dotdash32/VoronUsers/printer_mods/Dotdash32/SKR_E3_Mini_V2_Expanders/ThermistorExpander-kicad/THermistorExpander-kicad_toLCSC.csv

Manufacture Part Number | Description | Value | Manufacturer | LCSC Part Number | Quantity | Unit Price | Order Price | $1.02
GRM21BR61H106KE43L | C2, C3, C4, | 10uF | Murata Electronics | C440198 | 3 | $0.1030 | $0.31
PM254V-12-08-H85 | J1 | SPI_Header | XFCN | C541854 | 1 | $0.1424 | $0.14
B2B-XH-AM(LF)(SN) | J2, J3, J4 | JST-XH-B2B | JST Sales America | C161869 | 3 | $0.0512 | $0.15
XHP-2 | J2-4 Housings | JST-XHP-2 | JST Sales America | C144401 | 3 | $0.0221 | $0.07
SXH-002T-P0.6 | J2-4 crimps | SXH | JST Sales America | C495681 | 6 | $0.0586 | $0.35
