dotdash32/VoronUsers/printer_mods/Dotdash32/SKR_E3_Mini_V2_Expanders/FanExpander-Lite/FanExpander-Lite.step

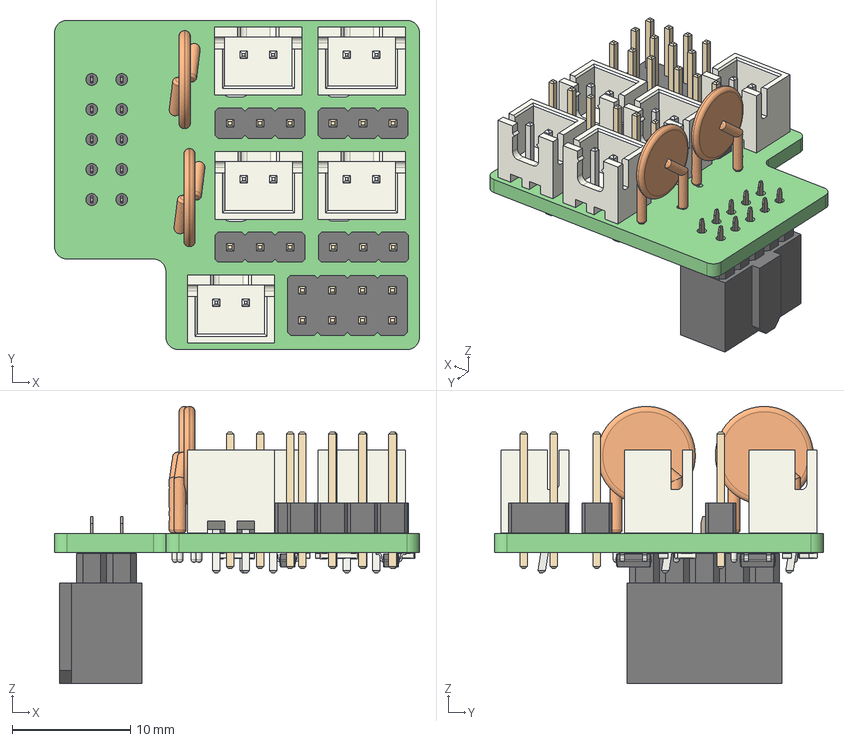
[picture p1: CAD file, 2022-02-04]
printer_mods/Dotdash32/SKR_E3_Mini_V2_Expanders/FanExpander-Lite/FanExpander-Lite.step
30.9 x 27.9 x 23.4 mm
_autosave-FanExpander-Lite PCB
