dotdash32/VoronUsers/printer_mods/Dotdash32/SKR_E3_Mini_V2_Expanders/Solder-Stencils/Fan-exp/FanExpander-kicad-Edge_Cuts.dxf

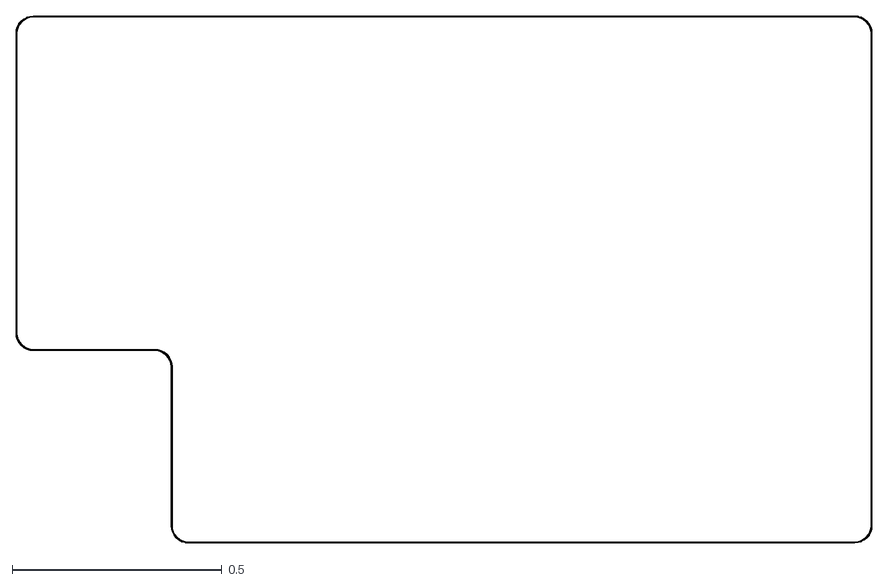
[picture p2: CAD file, 2022-02-01]
printer_mods/Dotdash32/SKR_E3_Mini_V2_Expanders/Solder-Stencils/Fan-exp/FanExpander-kicad-Edge_Cuts.dxf
2.04 x 1.26
