dotdash32/VoronUsers/printer_mods/Dotdash32/SKR_E3_Mini_V2_Expanders/Solder-Stencils/FEL/FanExpander-Lite-Edge_Cuts.dxf

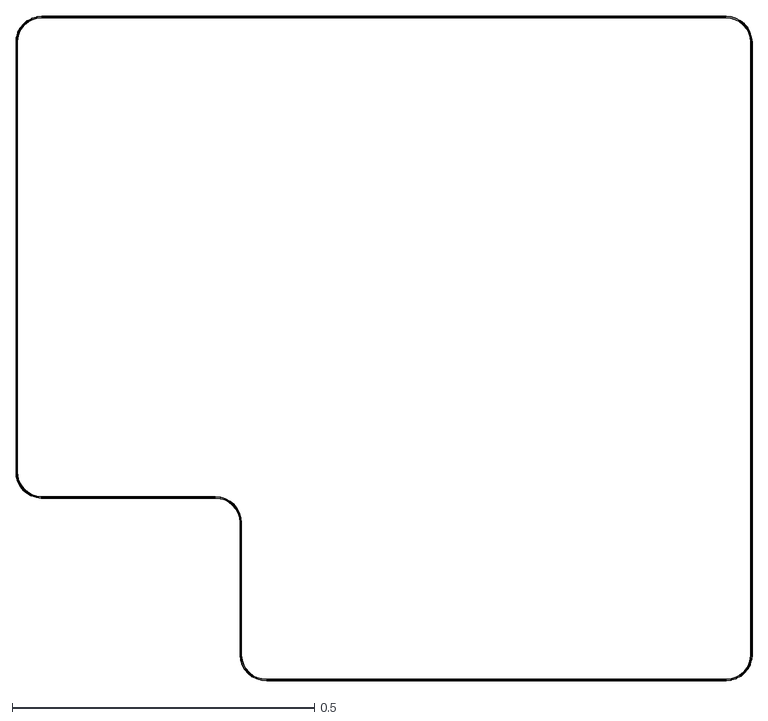
[picture p3: CAD file, 2022-02-01]
printer_mods/Dotdash32/SKR_E3_Mini_V2_Expanders/Solder-Stencils/FEL/FanExpander-Lite-Edge_Cuts.dxf
1.22 x 1.10
