dotdash32/VoronUsers/printer_mods/Dotdash32/SKR_E3_Mini_V2_Expanders/Solder-Stencils/TH-exp/ThermistorExpander-kicad-Edge_Cuts.dxf

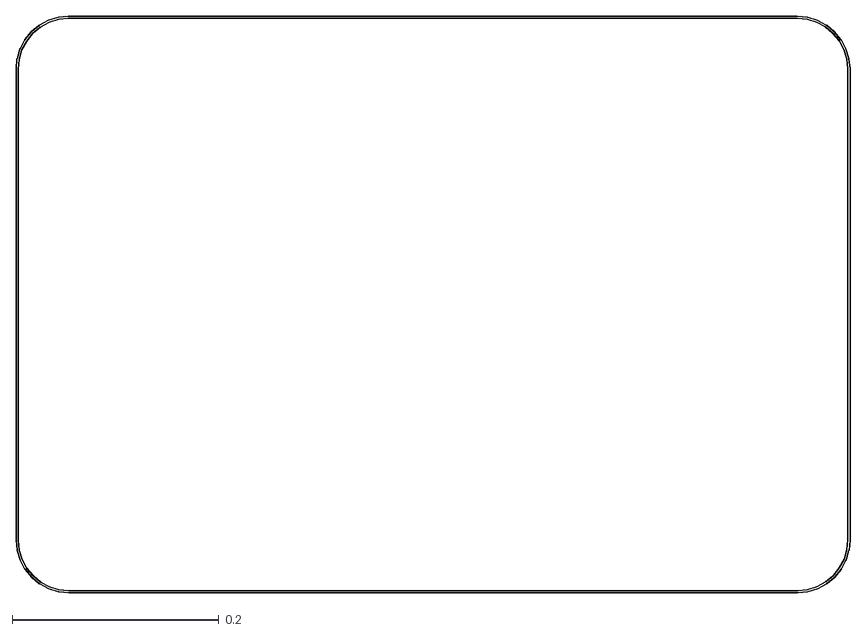
[picture p4: CAD file, 2022-02-01]
printer_mods/Dotdash32/SKR_E3_Mini_V2_Expanders/Solder-Stencils/TH-exp/ThermistorExpander-kicad-Edge_Cuts.dxf
0.806 x 0.557
