dotdash32/VoronUsers/printer_mods/Dotdash32/SKR_E3_Mini_V2_Expanders/ThermistorExpander-kicad/ThermistorExpander-kicad.step

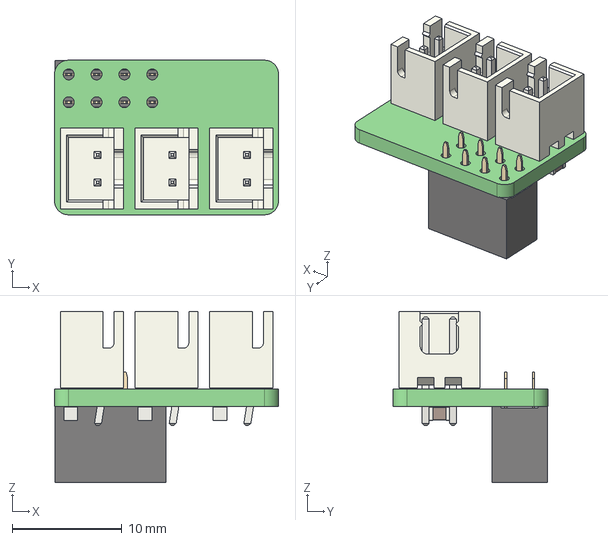
[picture p5: CAD file, 2022-02-04]
printer_mods/Dotdash32/SKR_E3_Mini_V2_Expanders/ThermistorExpander-kicad/ThermistorExpander-kicad.step
20.4 x 14.1 x 15.6 mm
ThermistorExpander-kicad PCB
