dotdash32/VoronUsers/printer_mods/Dotdash32/V0_X_Endstop_Bumper/[a]_X_Endstop_Bumper_MOD_x1.stl

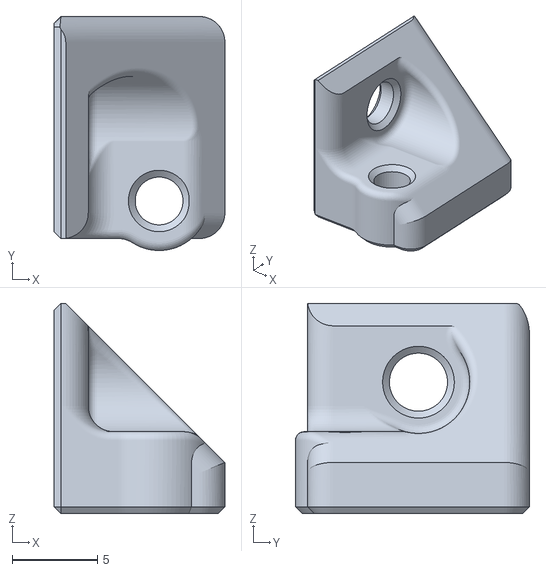
[picture p6: CAD file, 2021-11-23]
printer_mods/Dotdash32/V0_X_Endstop_Bumper/[a]_X_Endstop_Bumper_MOD_x1.stl
10.0 x 13.7 x 12.3
