dotdash32/VoronUsers/printer_mods/Dotdash32/V0_X_Endstop_Bumper/Z_Endstop_Biggener/screwBiggener.stl

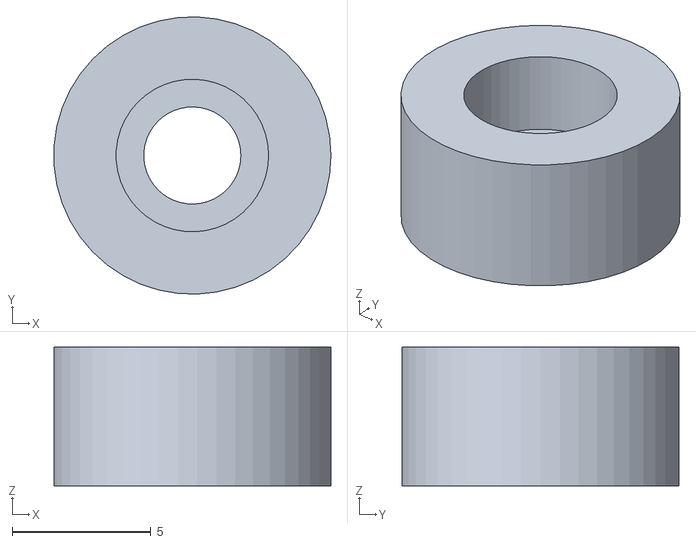
[picture p7: CAD file, 2021-11-25]
printer_mods/Dotdash32/V0_X_Endstop_Bumper/Z_Endstop_Biggener/screwBiggener.stl
9.99 x 9.99 x 5.00
