dotdash32/VoronUsers/(list of files, cad)

Other CAD files:
printer_mods/Dotdash32/V0_X_Endstop_Bumper/CAD/X_Endstop_Bumper_MOD.step
printer_mods/Dotdash32/SKR_E3_Mini_V2_Expanders/Solder-Stencils/FEL/FanExpander-Lite-B_Paste.dxf
printer_mods/Dotdash32/SKR_E3_Mini_V2_Expanders/Solder-Stencils/FEL/FanExpander-Lite-F_Paste.dxf
printer_mods/Dotdash32/SKR_E3_Mini_V2_Expanders/Solder-Stencils/Fan-exp/FanExpander-kicad-B_Paste.dxf
printer_mods/Dotdash32/SKR_E3_Mini_V2_Expanders/Solder-Stencils/Fan-exp/FanExpander-kicad-F_Paste.dxf
printer_mods/Dotdash32/SKR_E3_Mini_V2_Expanders/Solder-Stencils/TH-exp/ThermistorExpander-kicad-B_Paste.dxf
printer_mods/Dotdash32/SKR_E3_Mini_V2_Expanders/Solder-Stencils/TH-exp/ThermistorExpander-kicad-F_Paste.dxf
