dotdash32/VoronUsers/printer_mods/Dotdash32/SKR_E3_Mini_V2_Expanders/ThermistorExpander-kicad/readme.md

# Thermistor Expander

This PCB is probably not supremely useful, but it has a special place in my heart.

Here are some pretty pictures of what it looks like!

## Images

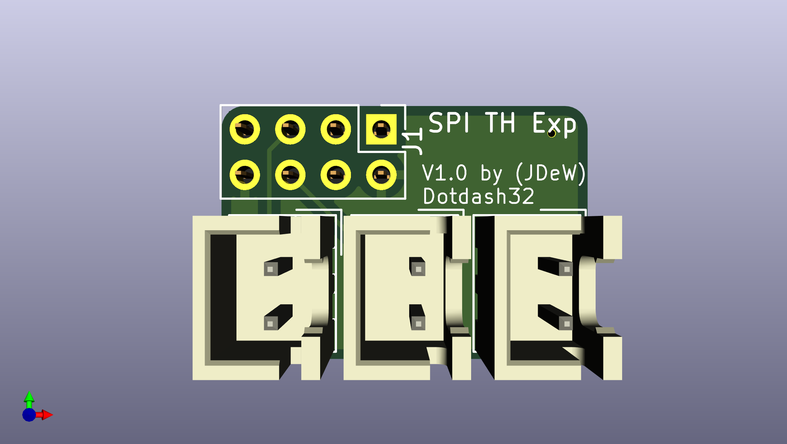
[picture p13: printer_mods/Dotdash32/SKR_E3_Mini_V2_Expanders/images/TH_EXP_topside.png]
topside


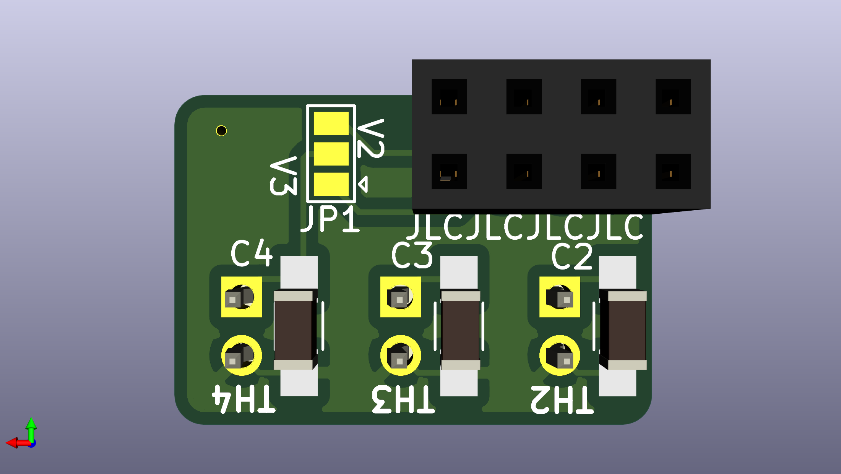
[picture p14: printer_mods/Dotdash32/SKR_E3_Mini_V2_Expanders/images/TH_EXP_underside.png]
underside


### Bill of Materials

See the Google Doc linked on the main page
