dotdash32/VoronUsers/printer_mods/Dotdash32/SKR_E3_Mini_V2_Expanders/FanExpander-Lite/FanExpander-Lite.html

# /Users/Josh/Documents/3D_Printing/VoronUsers/printer_mods/Dotdash32/SKR_E3_Mini_V2_Expanders/FanExpander-Lite/FanExpander-Lite.sch

Tuesday, January 04, 2022 at 09:40:46 AM

Eeschema (5.1.10-1-10_14)

Component Count:31

Ref | Qnty | Value | Part | Datasheet | Description | Vendor
D1, D2, D3, D4 | 4 | LED | Device:LED | ~ | LED generic
F1, F2 | 2 | MF-RHT200/32 | Device:Polyfuse | ~ | resettable fuse, polymeric positive temperature coefficient (PPTC)
J1, J2, J3, J4, J6 | 5 | JST-XH2 | Connector_Generic:Conn_01x02 | ~ | Generic connector, single row, 01x02, script generated (kicad-library-utils/schlib/autogen/connector/)
J5 | 1 | EXP1_IN | Connector_Generic:Conn_02x05_Odd_Even | ~ | Generic connector, double row, 02x05, odd/even pin numbering scheme (row 1 odd numbers, row 2 even numbers), script generated (kicad-library-utils/schlib/autogen/connector/)
J7 | 1 | IO_PassThrough | Connector_Generic:Conn_02x04_Odd_Even | ~ | Generic connector, double row, 02x04, odd/even pin numbering scheme (row 1 odd numbers, row 2 even numbers), script generated (kicad-library-utils/schlib/autogen/connector/)
JP1, JP2, JP3, JP4 | 4 | V_SELECT | Jumper:Jumper_3_Open | ~ | Jumper, 3-pole, both open
JP5 | 1 | LED_ENABLE | Jumper:SolderJumper_2_Bridged | ~ | Solder Jumper, 2-pole, closed/bridged
Q1, Q2, Q3 | 3 | IRLML6344 | Device:Q_NMOS_GSD | ~ | Transistor N-MOSFETwith substrate diode (general)
R1, R2, R5, R8 | 4 | 560R | Device:R_US | ~ | Resistor US symbol
R3, R6, R9 | 3 | 100R | Device:R_US | ~ | Resistor US symbol
R4, R7, R10 | 3 | 100k | Device:R_US | ~ | Resistor US symbol
