dotdash32/VoronUsers/printer_mods/Dotdash32/SKR_E3_Mini_V2_Expanders/images/FEL_bottom.png

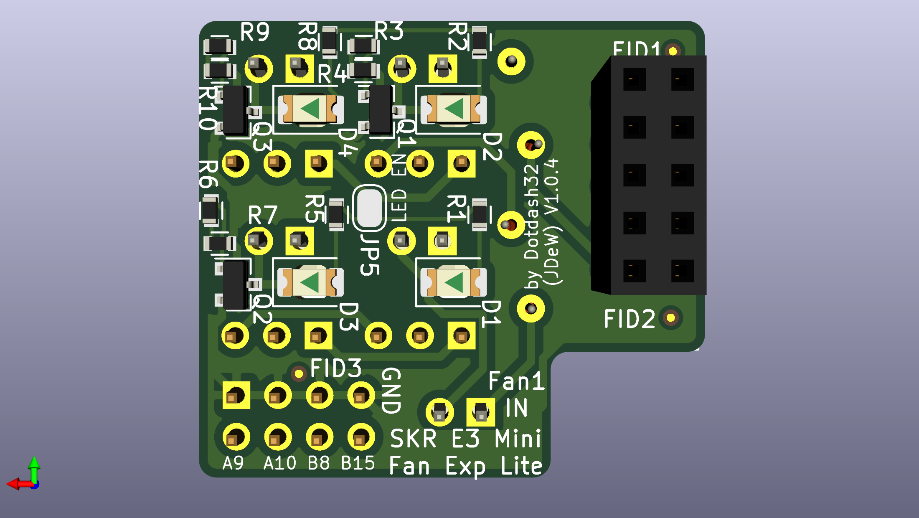
printer_mods/Dotdash32/SKR_E3_Mini_V2_Expanders/images/FEL_bottom.png
