dotdash32/VoronUsers/printer_mods/Dotdash32/SKR_E3_Mini_V2_Expanders/FanExpander-kicad/FanExpander-kicad.pdf

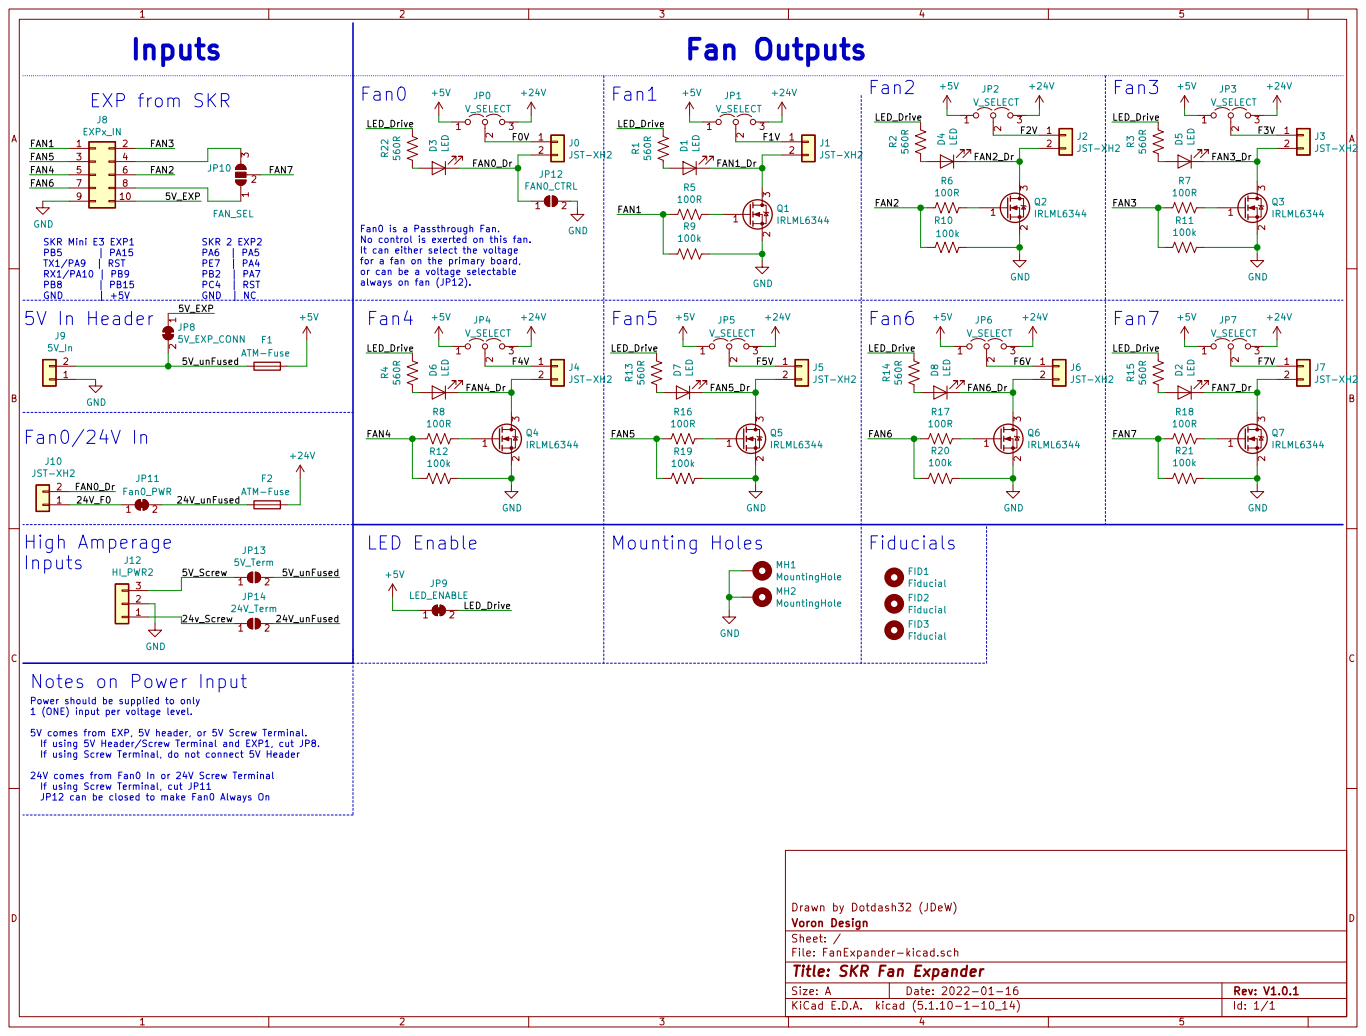
[picture p33: page 1]

Fan0 is a Passthrough Fan. No control is exerted on this fan.

always on fan (JP12). SKR 2 EXP2 PA6 | PA5

It can either select the voltage
for a fan on the primary board,
or can be a voltage selectable

Notes on Power Input

Power should be supplied to only
1 (ONE) input per voltage level. 5V comes from EXP, 5V header, or 5V Screw Terminal.

If using 5V Header/Screw Terminal and EXP1, cut JP8.
If using Screw Terminal, do not connect 5V Header 24V comes from Fan0 In or 24V Screw Terminal If using Screw Terminal, cut JP11

JP12 can be closed to make Fan0 Always On

Drawn by Dotdash32 (JDeW)
File: FanExpander-kicad.sch Sheet: / Voron Design

Id: 1/1 Title: SKR Fan Expander
