dotdash32/VoronUsers/printer_mods/Dotdash32/SKR_E3_Mini_V2_Expanders/FanExpander-Lite/FanExpander-Lite.pdf

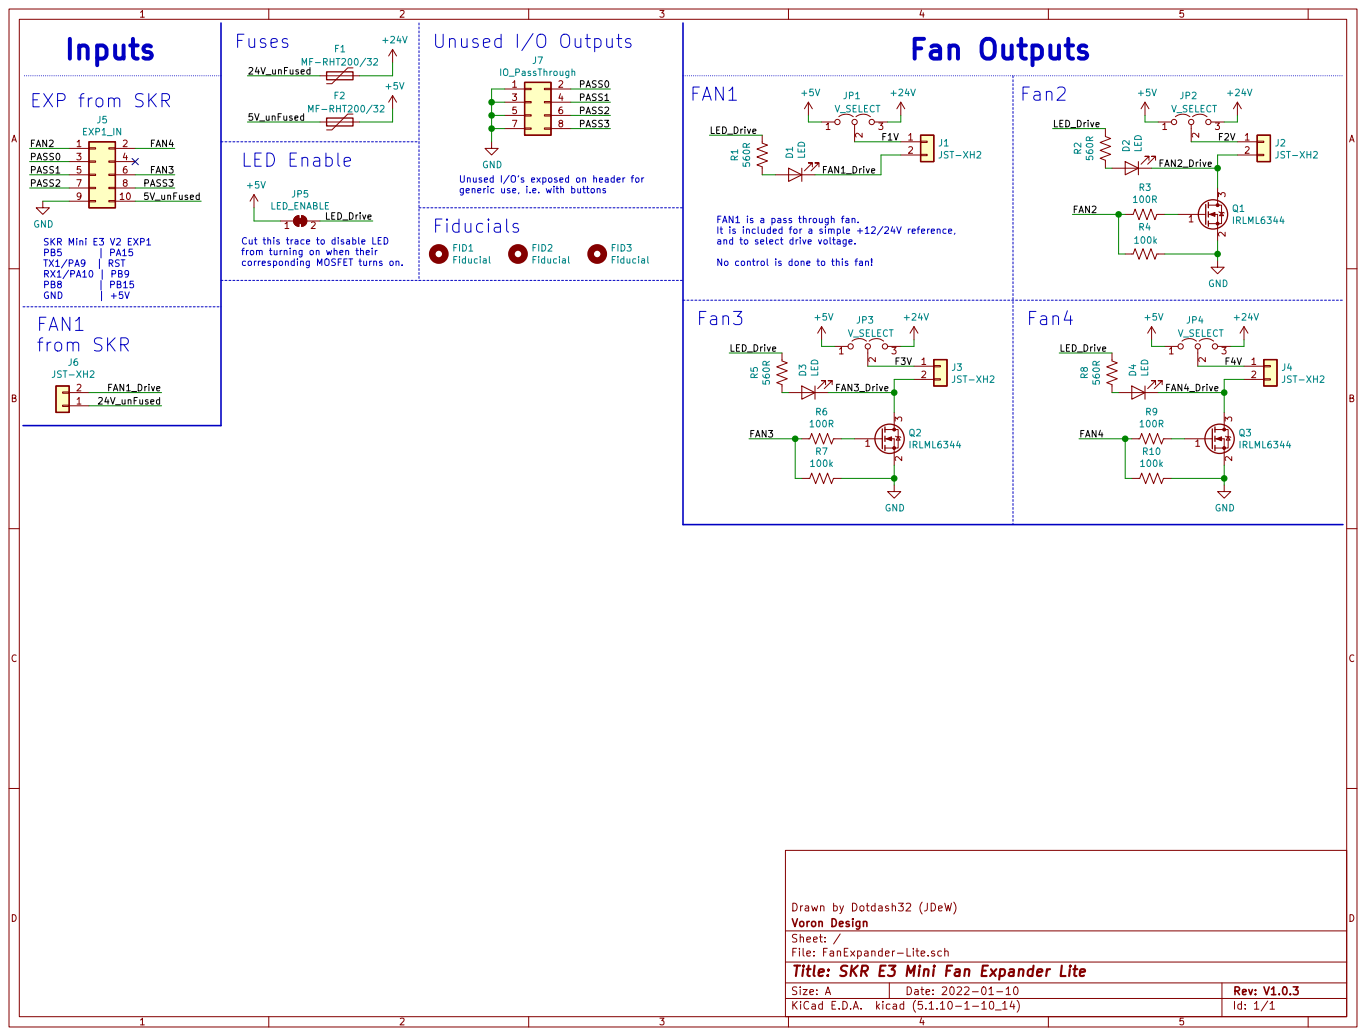
[picture p34: page 1]

and to select drive voltage. No control is done to this fan! Inputs

Unused I/Os exposed on header for
generic use, i.e. with buttons
Fiducials

FAN1 is a pass through fan.
It is included for a simple +12/24V reference,

from turning on when their
corresponding MOSFET turns on.

Drawn by Dotdash32 (JDeW)
File: FanExpander-Lite.sch Sheet: / Voron Design

Id: 1/1 Title: SKR E3 Mini Fan Expander Lite
