dotdash32/VoronUsers/printer_mods/Dotdash32/SKR_E3_Mini_V2_Expanders/ThermistorExpander-kicad/ThermistorExpander-kicad.pdf

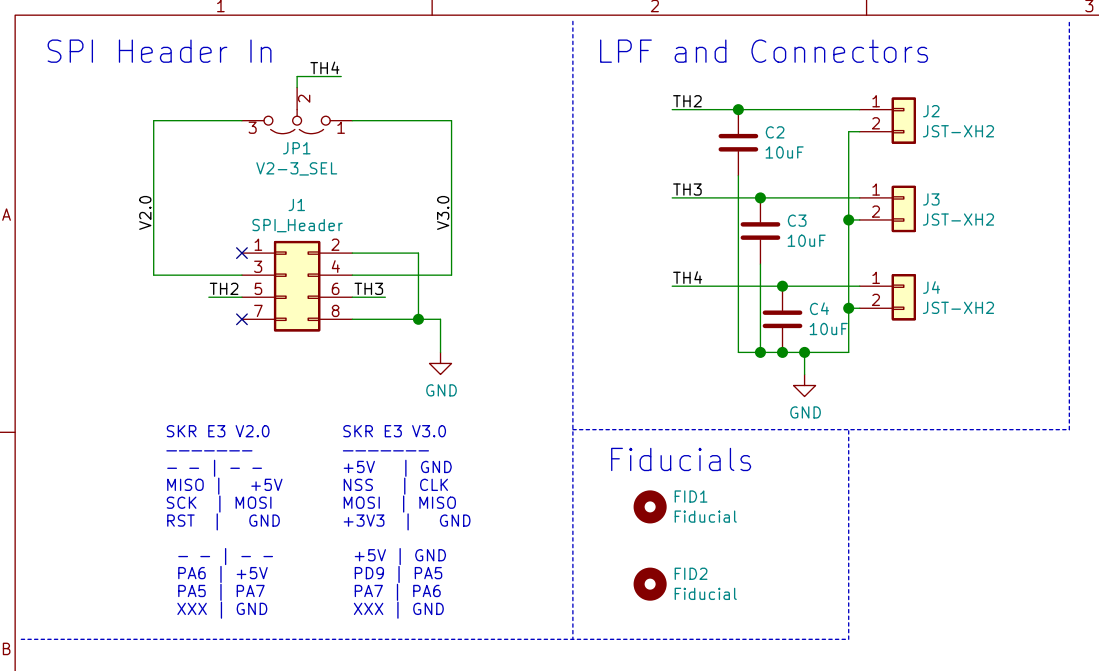
[picture p35: page 1]

Designed by Dotdash32 (JDeW)
File: ThermistorExpander-kicad.sch Sheet: / Voron Design

Id: 1/1 Title: SPI Thermistor Expander
