dotdash32/VoronUsers/printer_mods/Dotdash32/SKR_E3_Mini_V2_Expanders/Solder-Stencils/Fan-exp/FanExpander-kicad-B_Paste.pdf

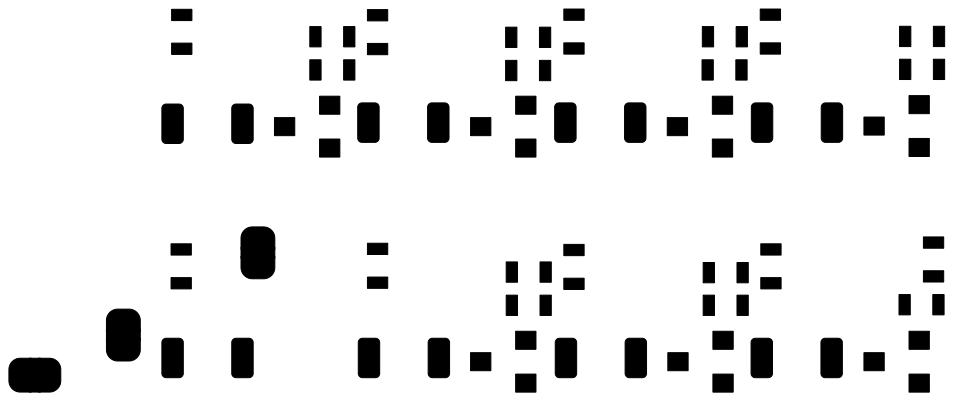
[picture p36: page 1]
