dotdash32/VoronUsers/printer_mods/Dotdash32/SKR_E3_Mini_V2_Expanders/Solder-Stencils/Fan-exp/FanExpander-kicad-Edge_Cuts.pdf

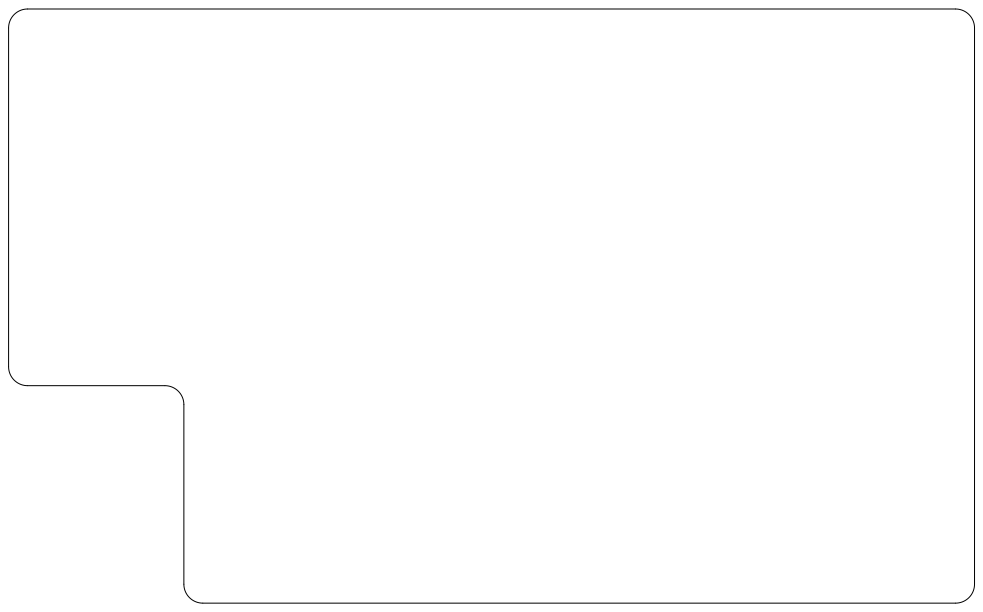
[picture p37: page 1]
