dotdash32/VoronUsers/printer_mods/Dotdash32/SKR_E3_Mini_V2_Expanders/Solder-Stencils/FEL/FanExpander-Lite-B_Paste.pdf

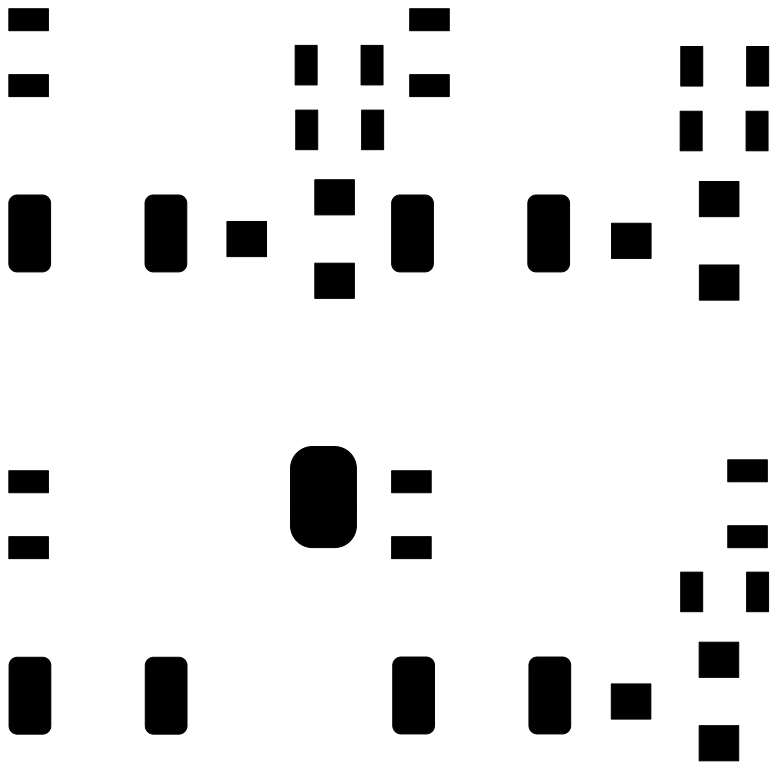
[picture p38: page 1]
