dotdash32/VoronUsers/printer_mods/Dotdash32/SKR_E3_Mini_V2_Expanders/Solder-Stencils/FEL/FanExpander-Lite-Edge_Cuts.pdf

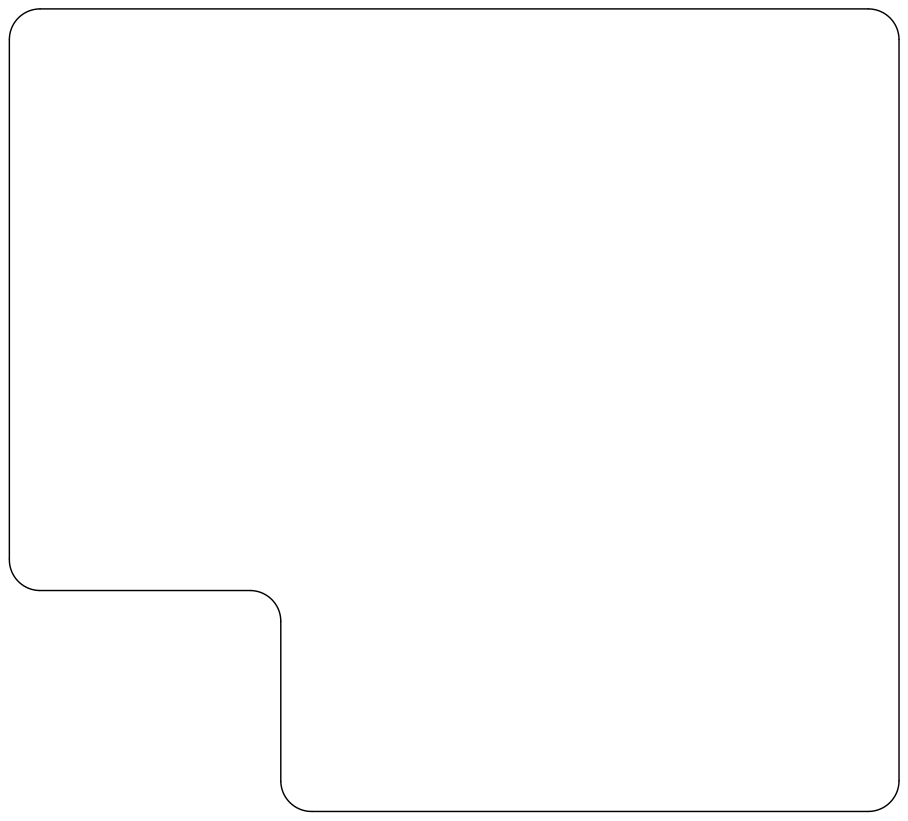
[picture p39: page 1]
