dotdash32/VoronUsers/printer_mods/Dotdash32/SKR_E3_Mini_V2_Expanders/Solder-Stencils/TH-exp/ThermistorExpander-kicad-Edge_Cuts.pdf

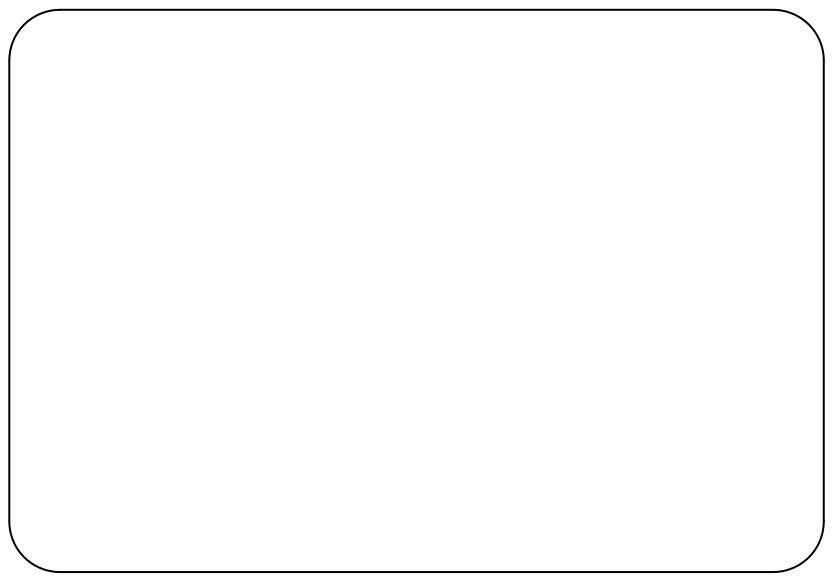
[picture p40: page 1]
