dotdash32/VoronUsers/printer_mods/Dotdash32/SKR_E3_Mini_V2_Expanders/LTspice_Sims/FET_Check/FET-LED_check.asc

D1: LED
M1: nmos; IRLML6344
R1: res; 100R
R2: res; 10k
R3: res; 560R
R4: res; 100R
V1: voltage; PULSE(0 3.3 {V_DRIVE *0.05} 100ns 100ns 75ms 5 1); AC 3.3 0
V2: voltage; 5V
V3: voltage; {V_DRIVE}
Named nets: 0, Drive
.tran 1.5s
.step param V_DRIVE list 3.3 5 12 24
