dotdash32/VoronUsers/printer_mods/Dotdash32/SKR_E3_Mini_V2_Expanders/LTspice_Sims/IO_Characteristics/PC14-switchingCurrent.asc

M1: nmos; IRLML6344
R1: res; 2.2k
R2: res; 10k
R3: res; 1.75
V1: voltage; 5
V2: voltage; PULSE(0 3.3 10us 75ns 50ns 25uS 1 1); AC 3.3 0
Named nets: 0, Drive
.tran .05ms
;.ac dec 10 .1 100Mega
;.step dec param DutyCycle 2e-6 .5 10
