dotdash32/VoronUsers/printer_mods/Dotdash32/SKR_E3_Mini_V2_Expanders/LTspice_Sims/AC_Analsysis/Thermistor_AC.asc

C1: cap; 10µ
R2: res; {r_pullup}
U2: NTCLE100E3104_B0
V1: voltage; 3.3; AC 3.3
Named nets: 0, SIG
.step TEMP 25 300 5
.param r_pullup 4.7k
;.step param r_pullup list 1k 4.7k 10k
.ac dec 10 .1 1000
;.op
