dotdash32/VoronUsers/printer_mods/Dotdash32/SKR_E3_Mini_V2_Expanders/FanExpander-kicad/FanExpander-kicad.kicad_pcb

## KiCad design printer_mods/Dotdash32/SKR_E3_Mini_V2_Expanders/FanExpander-kicad/FanExpander-kicad.kicad_pcb (2022-02-10)

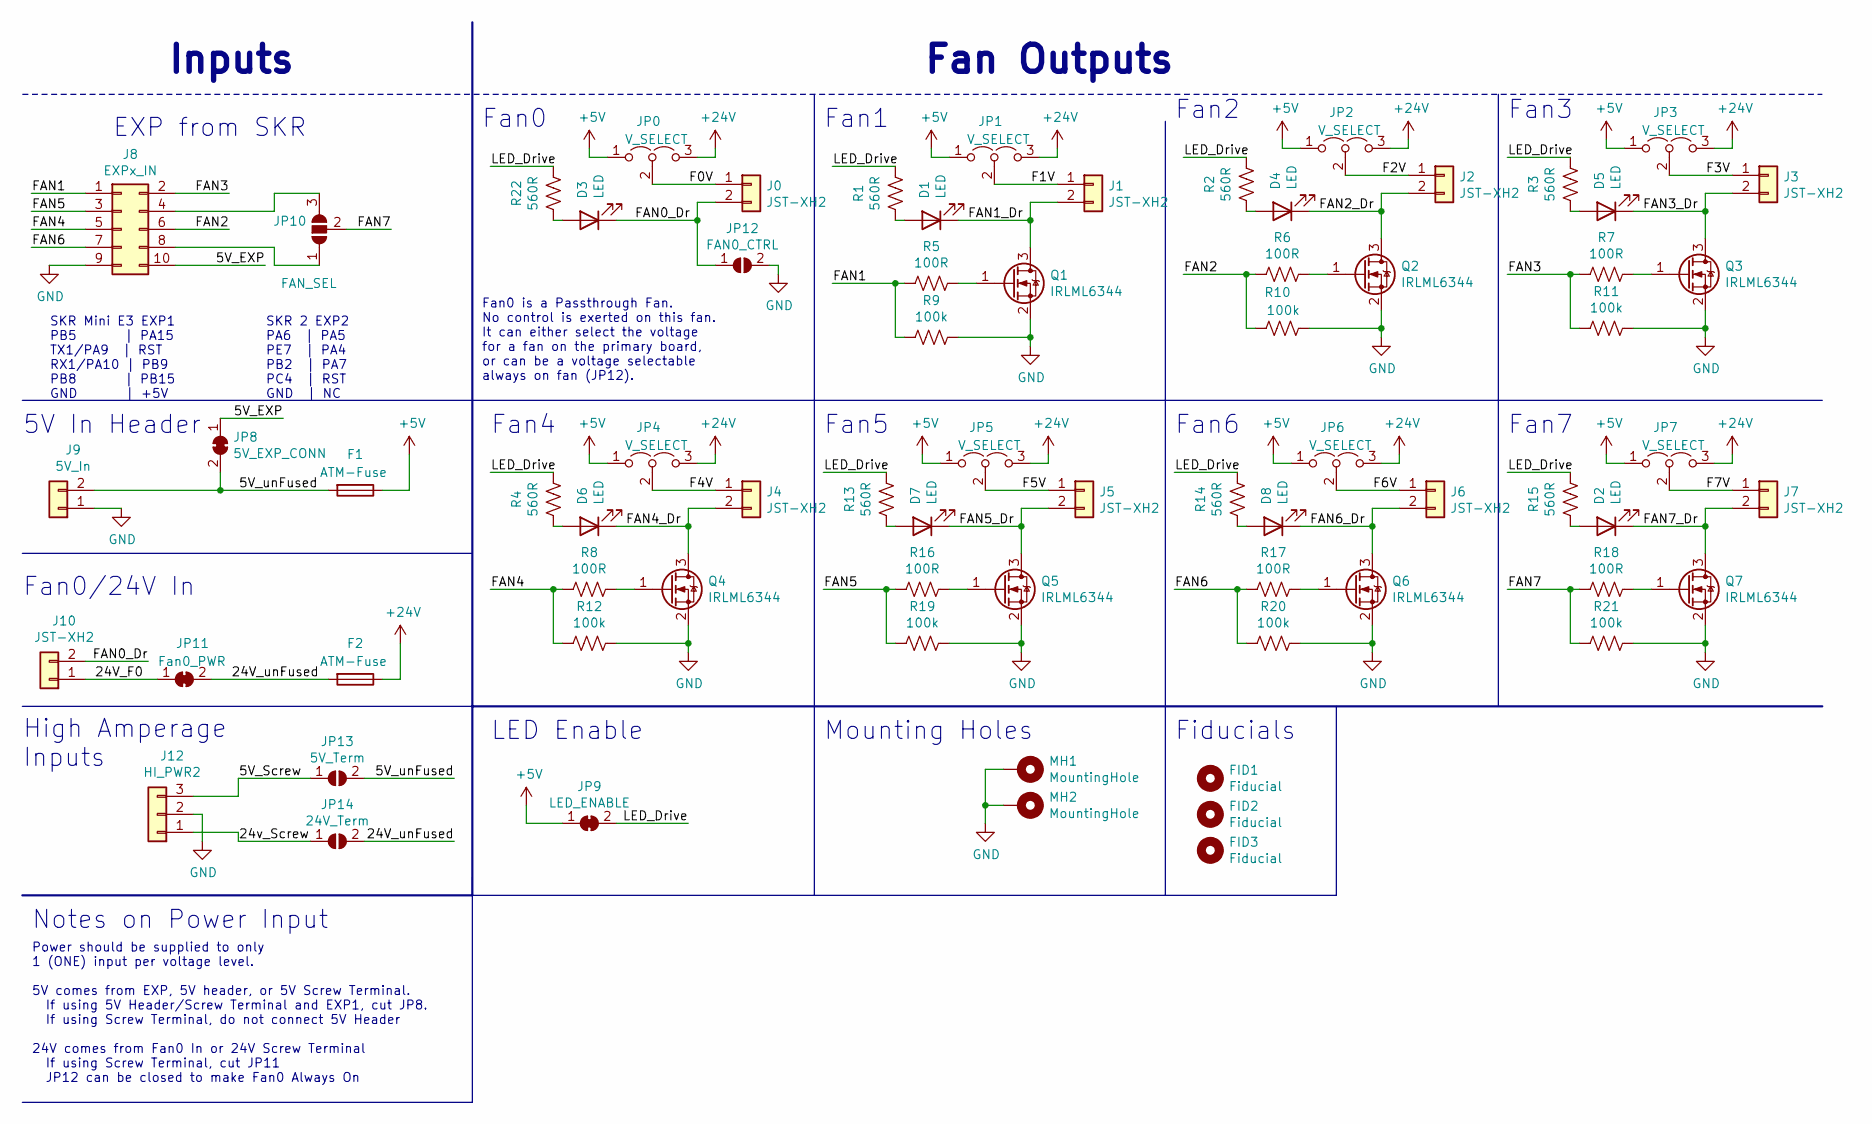
[picture p41: schematic FanExpander-kicad.kicad_sch, SKR Fan Expander]

Parts:
D1, D2, D3, D4, D5, D6, D7, D8: LED; LED_1206_3216Metric_ReverseMount_Hole2.1x2.1mm
F1, F2: ATM-Fuse; Fuseholder_Blade_Mini_Keystone_3544
FID1, FID2, FID3: Fiducial; Fiducial_0.5mm_Dia_1mm_Outer
J0, J1, J2, J3, J4, J5, J6, J7, J10: JST-XH2; JST_XH_B02B-XH-A_02x2.50mm_Straight
J8: EXPx_IN; Multicomp_MC9A12-1034_2x05x2.54mm_Straight
J9: 5V_In; Pin_Header_Straight_1x02_Pitch2.54mm
J12: HI_PWR2; TerminalBlock_Phoenix_MKDS-1,5-3-5.08_1x03_P5.08mm_Horizont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
JP0, JP1, JP2, JP3, JP4, JP5, JP6, JP7: V_SELECT; Pin_Header_Straight_1x03_Pitch2.54mm
JP8: 5V_EXP_CONN; SolderJumper-2_P1.3mm_Pasted_RoundedPad1.0x1.5mm
JP9: LED_ENABLE; SolderJumper-2_P1.3mm_Pasted_RoundedPad1.0x1.5mm
JP10: FAN_SEL; Pin_Header_Straight_1x03_Pitch1.27mm
JP11: Fan0_PWR; SolderJumper-2_P1.3mm_Pasted_RoundedPad1.0x1.5mm
JP12: FAN0_CTRL; SolderJumper-2_P1.3mm_Open_RoundedPad1.0x1.5mm
JP13: 5V_Term; SolderJumper-2_P1.3mm_Open_RoundedPad1.0x1.5mm
JP14: 24V_Term; SolderJumper-2_P1.3mm_Open_RoundedPad1.0x1.5mm
MH1, MH2: MountingHole; MountingHole_3.2mm_M3_Pad
Q1, Q2, Q3, Q4, Q5, Q6, Q7: IRLML6344; SOT-23
R1, R2, R3, R4, R13, R14, R15, R22: 560R; R_0603
R5, R6, R7, R8, R16, R17, R18: 100R; R_0603
R9, R10, R11, R12, R19, R20, R21: 100k; R_0603

Connections:
+5V: F1.1, JP0.1 (A), JP1.1 (A), JP2.1 (A), JP3.1 (A), JP4.1 (A), JP5.1 (A), JP6.1 (A), JP7.1 (A), JP9.1 (A)
+24V: F2.1, JP0.3 (B), JP1.3 (B), JP2.3 (B), JP3.3 (B), JP4.3 (B), JP5.3 (B), JP6.3 (B), JP7.3 (B)
/5V_EXP: J8.10, JP8.1 (A)
/5V_Screw: J12.3, JP13.1 (A)
/5V_unFused: F1.2, J9.2, JP8.2 (B), JP13.2 (B)
/24V_F0: J10.1, JP11.1 (A)
/24V_unFused: F2.2, JP11.2 (B), JP14.2 (B)
/24v_Screw: J12.1, JP14.1 (A)
/F0V: J0.1, JP0.2 (C)
/F1V: J1.1, JP1.2 (C)
/F2V: J2.1, JP2.2 (C)
/F3V: J3.1, JP3.2 (C)
/F4V: J4.1, JP4.2 (C)
/F5V: J5.1, JP5.2 (C)
/F6V: J6.1, JP6.2 (C)
/F7V: J7.1, JP7.2 (C)
/FAN0_Dr: D3.1 (K), J0.2, J10.2, JP12.1 (A)
/FAN1: J8.1, R5.2, R9.1
/FAN1_Dr: D1.1 (K), J1.2, Q1.3 (D)
/FAN2: J8.6, R6.2, R10.1
/FAN2_Dr: D4.1 (K), J2.2, Q2.3 (D)
/FAN3: J8.2, R7.2, R11.2
/FAN3_Dr: D5.1 (K), J3.2, Q3.3 (D)
/FAN4: J8.5, R8.2, R12.2
/FAN4_Dr: D6.1 (K), J4.2, Q4.3 (D)
/FAN5: J8.3, R16.2, R19.2
/FAN5_Dr: D7.1 (K), J5.2, Q5.3 (D)
/FAN6: J8.7, R17.2, R20.1
/FAN6_Dr: D8.1 (K), J6.2, Q6.3 (D)
/FAN7: JP10.2 (C), R18.2, R21.1
/FAN7_Dr: D2.1 (K), J7.2, Q7.3 (D)
/LED_Drive: JP9.2 (B), R1.2, R2.2, R3.2, R4.2, R13.2, R14.2, R15.2, R22.2
GND: J8.9, J9.1, J12.2, JP12.2 (B), MH1.1, MH2.1, Q1.2 (S), Q2.2 (S), Q3.2 (S), Q4.2 (S), Q5.2 (S), Q6.2 (S), Q7.2 (S), R9.2, R10.2, R11.1, R12.1, R19.1, R20.2, R21.2
unnamed: D1.2 (A), R1.1
unnamed: D2.2 (A), R15.1
unnamed: D3.2 (A), R22.1
unnamed: D4.2 (A), R2.1
unnamed: D5.2 (A), R3.1
unnamed: D6.2 (A), R4.1
unnamed: D7.2 (A), R13.1
unnamed: D8.2 (A), R14.1
unnamed: J8.4, JP10.3 (B)
unnamed: J8.8, JP10.1 (A)
unnamed: Q1.1 (G), R5.1
unnamed: Q2.1 (G), R6.1
unnamed: Q3.1 (G), R7.1
unnamed: Q4.1 (G), R8.1
unnamed: Q5.1 (G), R16.1
unnamed: Q6.1 (G), R17.1
unnamed: Q7.1 (G), R18.1

Notes on the sheet:
EXP from SKR
Fan1
Fan0 is a Passthrough Fan. No control is exerted on this fan. It can either select the voltage for a fan on the primary board, or can be a voltage selectable always on fan (JP12).
Fan0/24V In
Fan7
5V In Header
SKR 2 EXP2 PA6 | PA5 PE7 | PA4 PB2 | PA7 PC4 | RST GND | NC
Fan5
Mounting Holes
Notes on Power Input
Fan Outputs
LED Enable
Fan3
Fiducials
Fan0
SKR Mini E3 EXP1 PB5 | PA15 TX1/PA9 | RST RX1/PA10 | PB9 PB8 | PB15 GND | +5V
High Amperage Inputs
Fan4
Inputs
Fan6
Fan2
Power should be supplied to only 1 (ONE) input per voltage level. 5V comes from EXP, 5V header, or 5V Screw Terminal. If using 5V Header/Screw Terminal and EXP1, cut JP8. If using Screw Terminal, do not connect 5V Header 24V comes from Fan0 In or 24V Screw Terminal If using Screw Terminal, cut JP11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

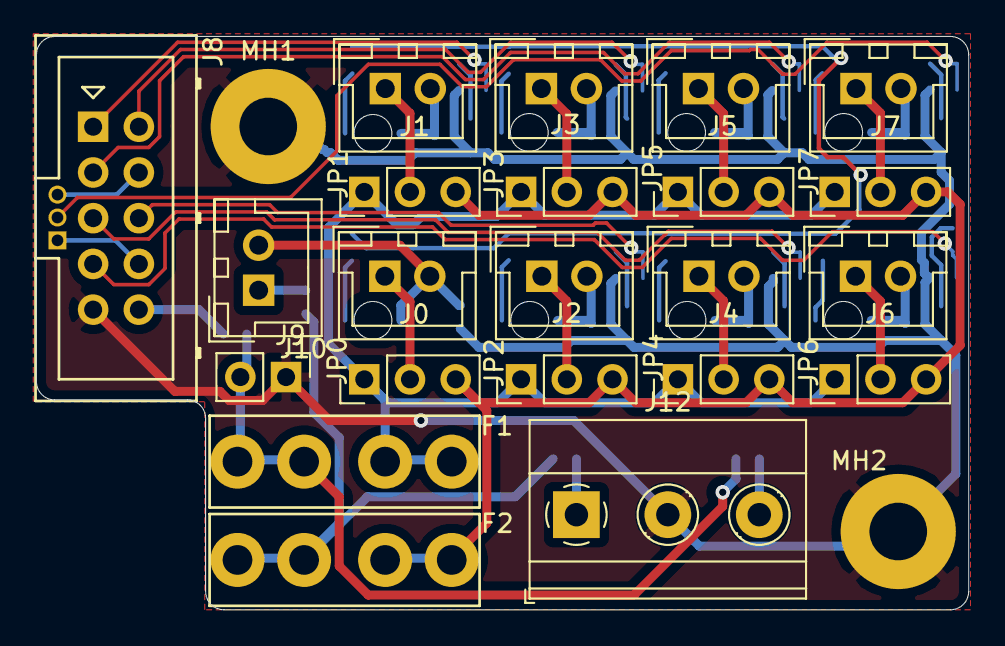
[picture p42: board FanExpander-kicad.kicad_pcb from above]

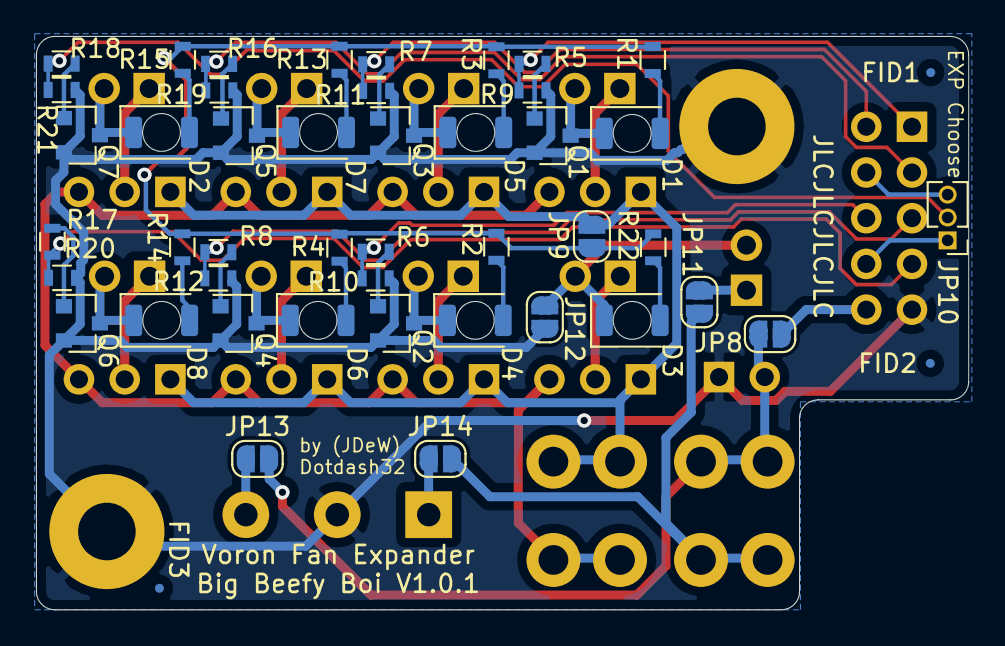
[picture p43: board FanExpander-kicad.kicad_pcb from below]

Board: 2 copper layers, 51.8 x 31.9 mm, 71 parts (47 on the bottom side), 50 nets.
