dotdash32/VoronUsers/printer_mods/Dotdash32/SKR_E3_Mini_V2_Expanders/ThermistorExpander-kicad/ThermistorExpander-kicad.kicad_pcb

## KiCad design printer_mods/Dotdash32/SKR_E3_Mini_V2_Expanders/ThermistorExpander-kicad/ThermistorExpander-kicad.kicad_pcb (2022-02-04)

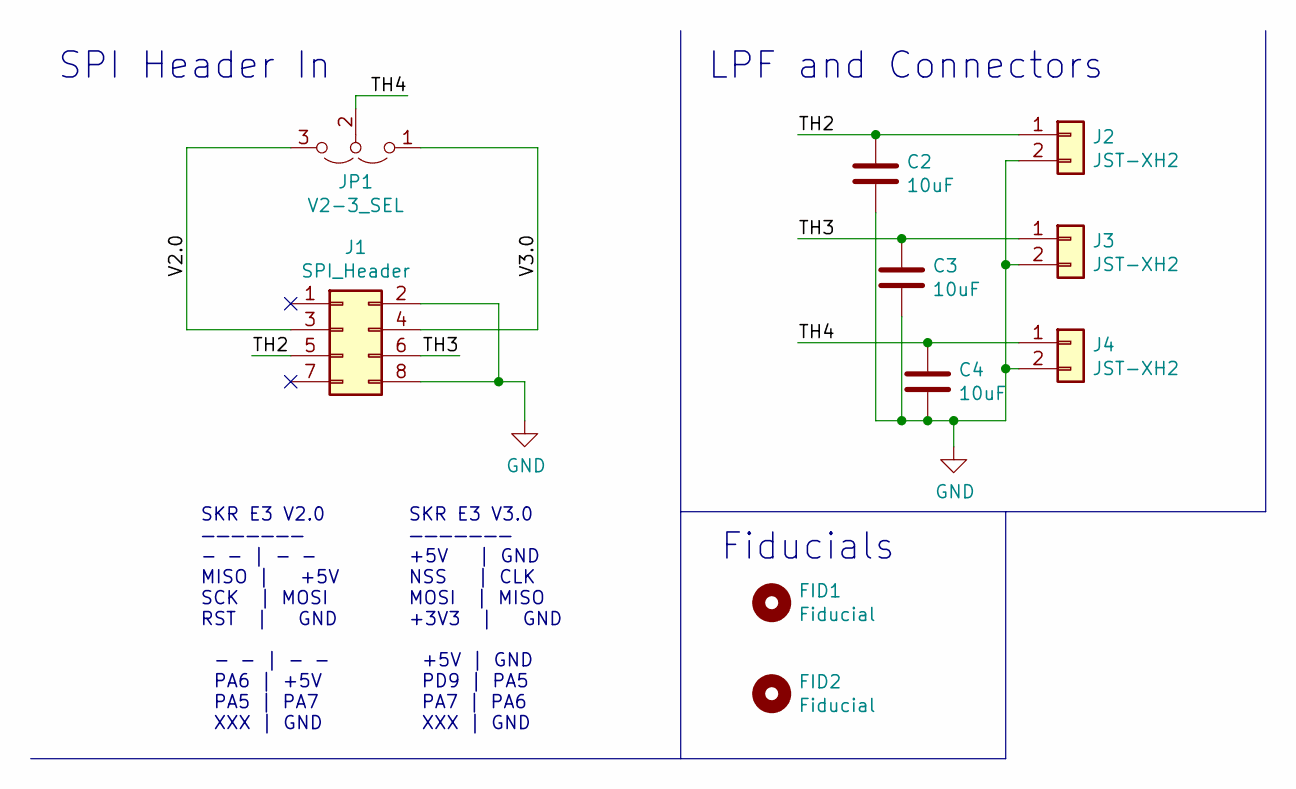
[picture p44: schematic ThermistorExpander-kicad.kicad_sch, SPI Thermistor Expander]

Parts:
C2, C3, C4: 10uF; C_0805_HandSoldering
FID1, FID2: Fiducial; Fiducial_0.5mm_Dia_1mm_Outer
J1: SPI_Header; Pin_Header_Straight_2x04_Pitch2.54mm
J2, J3, J4: JST-XH2; JST_XH_B02B-XH-A_02x2.50mm_Straight
JP1: V2-3_SEL; SolderJumper-3_P1.3mm_Open_Pad1.0x1.5mm

Connections:
/TH2: C2.1, J1.5, J2.1
/TH3: C3.1, J1.6, J3.1
/TH4: C4.1, J4.1, JP1.2 (C)
/V2.0: J1.3, JP1.3 (B)
/V3.0: J1.4, JP1.1 (A)
GND: C2.2, C3.2, C4.2, J1.2, J1.8, J2.2, J3.2, J4.2

Notes on the sheet:
- - | - - PA6 | +5V PA5 | PA7 XXX | GND
SPI Header In
LPF and Connectors
SKR E3 V2.0 ——————— - - | - - MISO | +5V SCK | MOSI RST | GND
Fiducials
+5V | GND PD9 | PA5 PA7 | PA6 XXX | GND
SKR E3 V3.0 ——————— +5V | GND NSS | CLK MOSI | MISO +3V3 | GND

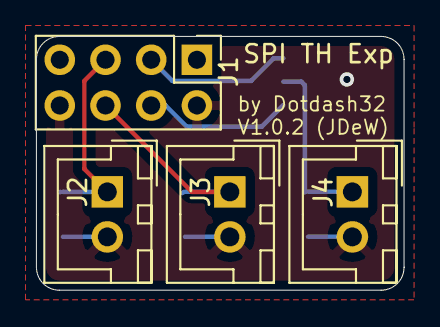
[picture p45: board ThermistorExpander-kicad.kicad_pcb from above]

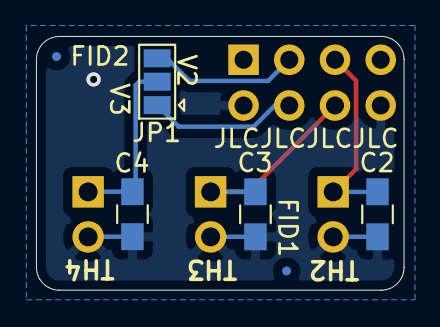
[picture p46: board ThermistorExpander-kicad.kicad_pcb from below]

Board: 2 copper layers, 20.4 x 14.1 mm, 10 parts (6 on the bottom side), 6 nets.
