dotdash32/VoronUsers/printer_mods/Dotdash32/SKR_E3_Mini_V2_Expanders/FanExpander-Lite/FanExpander-Lite.kicad_pcb

## KiCad design printer_mods/Dotdash32/SKR_E3_Mini_V2_Expanders/FanExpander-Lite/FanExpander-Lite.kicad_pcb (2022-02-04)

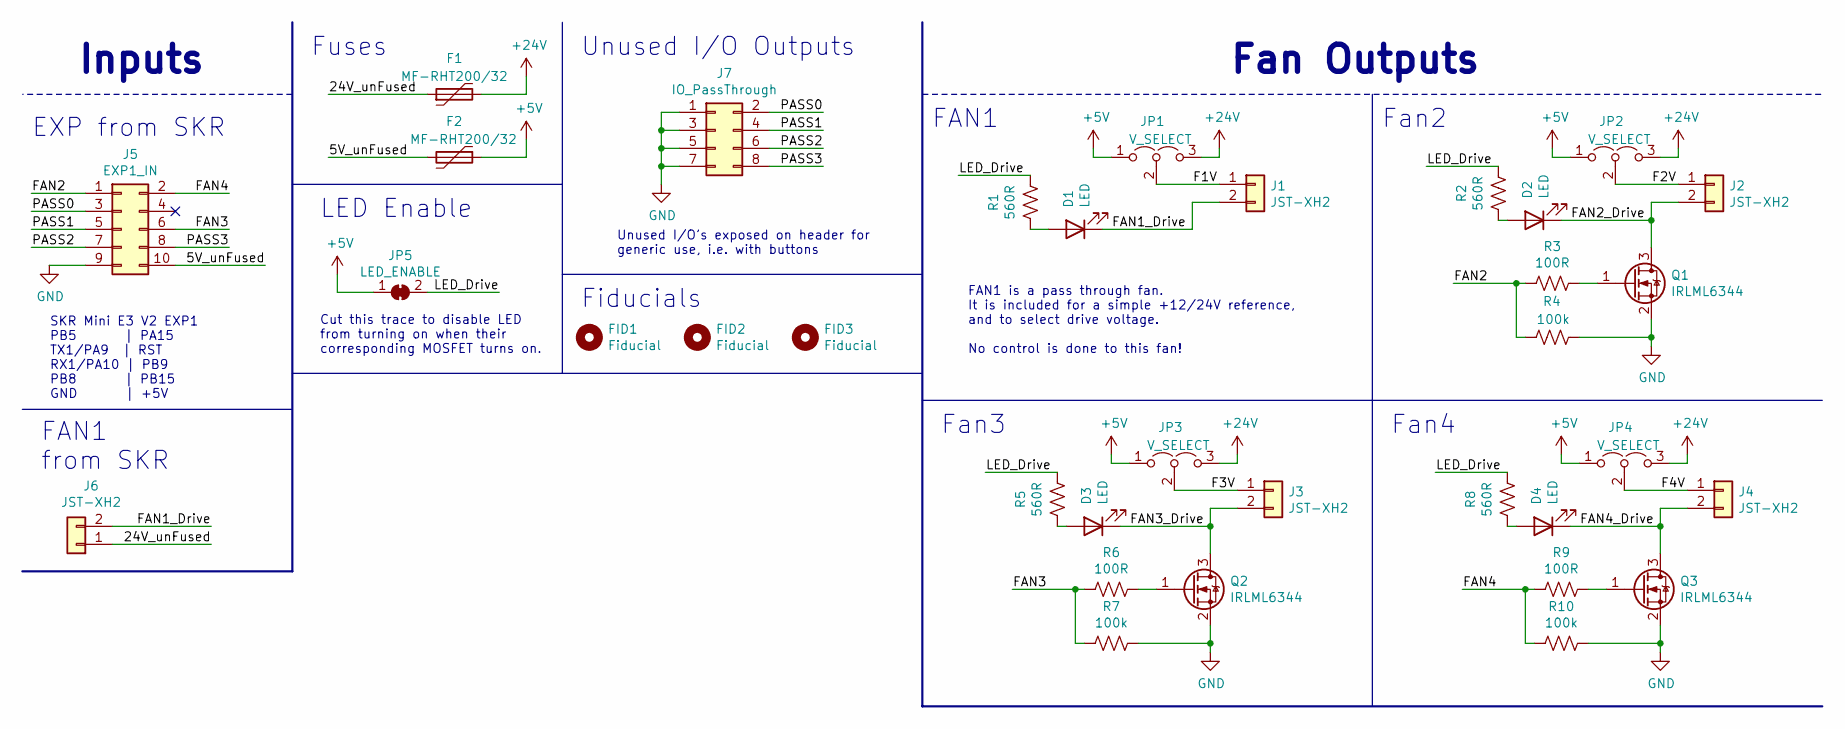
[picture p47: schematic FanExpander-Lite.kicad_sch, SKR E3 Mini Fan Expander Lite]

Parts:
D1, D2, D3, D4: LED; LED_1206_3216Metric_ReverseMount_Hole2.1x2.1mm
F1, F2: MF-RHT200/32; Fuse_Bourns_MF-RHT200
FID1, FID2, FID3: Fiducial; Fiducial_0.5mm_Dia_1mm_Outer
J1, J2, J3, J4, J6: JST-XH2; JST_XH_B02B-XH-A_02x2.50mm_Straight
J5: EXP1_IN; Multicomp_MC9A12-1034_2x05x2.54mm_Straight
J7: IO_PassThrough; Pin_Header_Straight_2x04_Pitch2.54mm
JP1, JP2, JP3, JP4: V_SELECT; Pin_Header_Straight_1x03_Pitch2.54mm
JP5: LED_ENABLE; SolderJumper-2_P1.3mm_Pasted_RoundedPad1.0x1.5mm
Q1, Q2, Q3: IRLML6344; SOT-23
R1, R2, R5, R8: 560R; R_0603
R3, R6, R9: 100R; R_0603
R4, R7, R10: 100k; R_0603

Connections:
+5V: F2.1, JP1.1 (A), JP2.1 (A), JP3.1 (A), JP4.1 (A), JP5.1 (A)
+24V: F1.2, JP1.3 (B), JP2.3 (B), JP3.3 (B), JP4.3 (B)
/5V_unFused: F2.2, J5.10
/24V_unFused: F1.1, J6.1
/F1V: J1.1, JP1.2 (C)
/F2V: J2.1, JP2.2 (C)
/F3V: J3.1, JP3.2 (C)
/F4V: J4.1, JP4.2 (C)
/FAN1_Drive: D1.1 (K), J1.2, J6.2
/FAN2: J5.1, R3.2, R4.1
/FAN2_Drive: D2.1 (K), J2.2, Q1.3 (D)
/FAN3: J5.6, R6.2, R7.2
/FAN3_Drive: D3.1 (K), J3.2, Q2.3 (D)
/FAN4: J5.2, R9.2, R10.2
/FAN4_Drive: D4.1 (K), J4.2, Q3.3 (D)
/LED_Drive: JP5.2 (B), R1.2, R2.2, R5.2, R8.2
/PASS0: J5.3, J7.2
/PASS1: J5.5, J7.4
/PASS2: J5.7, J7.6
/PASS3: J5.8, J7.8
GND: J5.9, J7.1, J7.3, J7.5, J7.7, Q1.2 (S), Q2.2 (S), Q3.2 (S), R4.2, R7.1, R10.1
unnamed: D1.2 (A), R1.1
unnamed: D2.2 (A), R2.1
unnamed: D3.2 (A), R5.1
unnamed: D4.2 (A), R8.1
unnamed: Q1.1 (G), R3.1
unnamed: Q2.1 (G), R6.1
unnamed: Q3.1 (G), R9.1

Notes on the sheet:
Fan4
SKR Mini E3 V2 EXP1 PB5 | PA15 TX1/PA9 | RST RX1/PA10 | PB9 PB8 | PB15 GND | +5V
Fan3
Fan Outputs
LED Enable
EXP from SKR
Fiducials
Inputs
FAN1 from SKR
FAN1
FAN1 is a pass through fan. It is included for a simple +12/24V reference, and to select drive voltage. No control is done to this fan!
Unused I/O Outputs
Fan2
Fuses
Cut this trace to disable LED from turning on when their corresponding MOSFET turns on.
Unused I/O’s exposed on header for generic use, i.e. with buttons

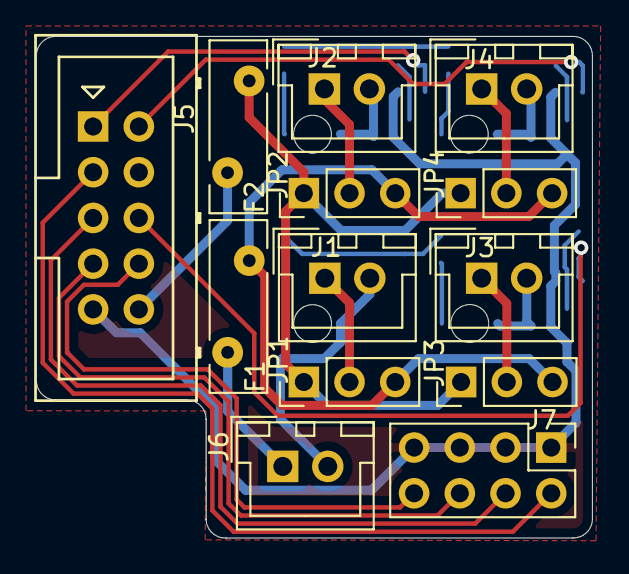
[picture p48: board FanExpander-Lite.kicad_pcb from above]

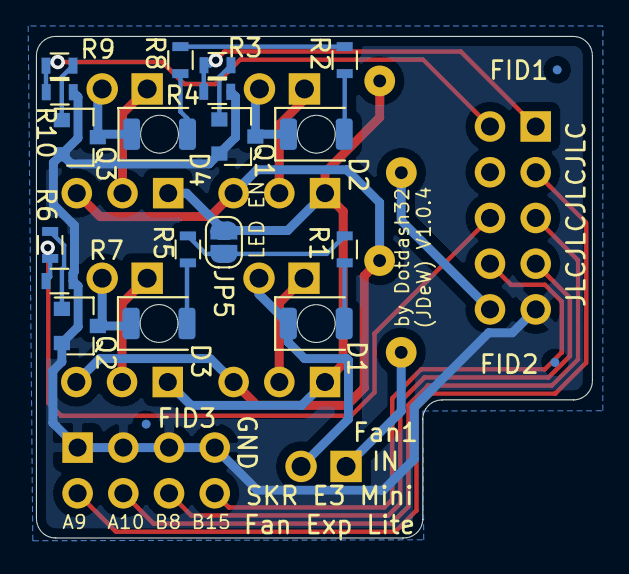
[picture p49: board FanExpander-Lite.kicad_pcb from below]

Board: 2 copper layers, 30.9 x 27.9 mm, 34 parts (21 on the bottom side), 28 nets.
