dotdash32/VoronUsers/(commit log)

2021-11-23 feat: add X endstop bumper Mod STL
    [[a]_X_Endstop_Bumper_MOD_x1.stl]
2021-11-23 chore: add full source files with assembly contexts
    [X_Endstop_Bumper_MOD.step]
2021-11-25 feat: add Z endstop embiggener, materials needed
    [screwBiggener.scad, screwBiggener.stl]
2021-11-25 feat: thermistor expander schematic
    [ThermistorExpander-kicad.kicad_pcb, ThermistorExpander-kicad.sch]
2021-11-26 feat: fan expander PCB
    [FanExpander-kicad.kicad_pcb, FanExpander-kicad.sch]
2021-11-27 chore: change fan2 and 3 numbering
    [FanExpander-kicad.sch]
2021-12-13 test: LTspice circuit for varying pullup values
    examine the AC (cutoff frequency) and DC characteristics
    and affects of the standard thermistor pullup by changing the
    value of the pullup resistor.
    I never actually got around to graphing cutoff frequency as a function
    of temperature (which was the OG goal), but got some interesting
    data nonetheless.
2021-12-15 feat: PCB init layout and 3d connector models
    [ThermistorExpander-kicad.kicad_pcb, ThermistorExpander-kicad.sch]
2021-12-17 feat: create .STEP export and first image
    [ThermistorExpander-kicad.kicad_pcb, ThermistorExpander-kicad.step]
2021-12-17 feat: move JST headers to avoid EXP1 port
    but now interfering with the USB port, which is more useful.
    So maybe we try to use the vertical headers and admit defeat?
    sad bears, sad beers
    [ThermistorExpander-kicad.kicad_pcb, ThermistorExpander-kicad.step]
2021-12-17 feat: use straight JSTs, clear existing SKR ports
    [ThermistorExpander-kicad.kicad_pcb, ThermistorExpander-kicad.sch, ThermistorExpander-kicad.step]
2021-12-17 fix: actually route the traces please
    [ThermistorExpander-kicad.kicad_pcb]
2021-12-17 docs: information for TH EXP assembly, pics
2021-12-17 docs: LED leakage current analysis
2021-12-17 feat: new fan expander using EXP1 header
    [FanExpander-kicad.sch]
2021-12-18 feat: init footprints, rename connectors per use
    [FanExpander-kicad.sch]
2021-12-18 test: initial layout, trying different mosfet arrs
    testing different arragnments of Mosfets and associated
    hardware, seeing the best routing and labelling way.
    Trying to keep the designators on the board, which takes up space,
    but in general i think i need to make things more sparse.
    [FanExpander-kicad.sch]
2021-12-19 feat: no ADC in EXP1, add more fans!!!
    [FanExpander-kicad.kicad_pcb, FanExpander-kicad.sch]
2021-12-19 feat: create "Lite" Fan Expander with 3 MOSFETs
    it's smaller and more minimalistic. SMD polyfuses,
    no screw terminals, all JST connections.
    Probably not what Timmit99 had envisioned, but I think this is
    going to be easier to "sell".
    [FanExpander-Lite.kicad_pcb, FanExpander-Lite.sch]
2021-12-19 feat: init routing of Lite board
    [FanExpander-Lite.kicad_pcb, FanExpander-Lite.sch]
2021-12-19 chore: cleanup edges, silkscreen, making pretty
    [FanExpander-Lite.kicad_pcb, FanExpander-Lite.sch]
2021-12-19 docs: overview of FELite and operation
    [FanExpander-Lite.kicad_pcb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]
2021-12-22 feat: beefy expander sch cleaned, initial layout
    schematic looks good, but the layout needs work.
    RN, it covers too much, so needs to have the EXP header stick out
    a lot more than it already is, probably make the whole thing longer
    [FanExpander-kicad.kicad_pcb, FanExpander-kicad.sch]
2021-12-23 test: using 1xXX pins for breakaways?
    [FanExpander-kicad.kicad_pcb, FanExpander-kicad.sch]
2021-12-23 feat: breakaway layout, using 1mm spacing headers
    it works, but its SOOO LOOOONG, going to try again and make it
    more compact so I don't feel bad about this long stick in my printer
2021-12-24 feat: move SMD components to bottom for sizing
    this really messes with the designator cleanliness, but alas,
    sacrifices must be made. It's really smalll now!
    Also some schematic cleaning. Should there be a second set of
    mounting holes next to the connector? unclear...
    [FanExpander-kicad.kicad_pcb, FanExpander-kicad.sch]
2021-12-25 chore: trying routing, running into obstacles
    no room to route the control wires, everything else is *almost*
    there though.
2022-01-02 feat: re-routing, pre-terminal blocks
    A bunch of routing work, but i'm not fully happy with it, still.
    new plan is to mess around and add back the terminal blocks, as well
    as move back to full size ATM fuses.
    [FanExpander-kicad.kicad_pcb, FanExpander-kicad.sch]
2022-01-02 test: move to ATM fuses, keep breakaway
    I don't think the breakaway is actuall worthwhile??
    [FanExpander-kicad.sch]
2022-01-02 feat: new layout with screw terminals and jumpers
    add more jumpers to make any kind of voltage selection more easy,
    particularly for fan0, either always on or cutting 24V in
    no routing done yet lol
    [FanExpander-kicad.kicad_pcb, FanExpander-kicad.sch]
2022-01-02 feat: shrink TH_exp to be more space efficient
    [ThermistorExpander-kicad.kicad_pcb]
2022-01-02 chore: routing TH exp in new formfactor
    [ThermistorExpander-kicad.kicad_pcb]
2022-01-02 feat: redo layout to use backside SMD parts
    move to align with main board version, compactness!
    Also moving to larger THT PTC fuses
    [FanExpander-Lite.kicad_pcb, FanExpander-Lite.sch]
2022-01-04 feat: routing the board
    no external 5V tap, but it'll probably be fine??
    [FanExpander-Lite.kicad_pcb, FanExpander-Lite.sch]
2022-01-06 feat: add BOM files
    [FanExpander-Lite.csv]
2022-01-06 feat: trim outline to not collide with TH exp
    also some fun little changes for internal structure
    [FanExpander-Lite.kicad_pcb, FanExpander-Lite.sch]
2022-01-08 feat: cleaning and preping TH expander
    [ThermistorExpander-kicad.kicad_pcb, ThermistorExpander-kicad.step]
2022-01-09 feat|docs: 2x4 SPI header, readme updates
    also re-routing some silly decisions, cleaning schematic
    Also moving some readme-stuff around for
    [ThermistorExpander-kicad.kicad_pcb, ThermistorExpander-kicad.sch]
2022-01-09 test: LCSC larger THT capacitor
    it's sooo bigg though...
    [ThermistorExpander-kicad.kicad_pcb, ThermistorExpander-kicad.sch]
2022-01-09 feat: move to SMD capacitors for sourcing
    upsetti spaghetti, THT capacitors are hard to find, so we'll just
    use SMD (1206) capacitors
    [ThermistorExpander-kicad.kicad_pcb, ThermistorExpander-kicad.sch]
2022-01-09 chore: create gerbers for TH exp v1.0
    [ThermistorExpander-kicad-B_Cu.gbr, ThermistorExpander-kicad-B_Mask.gbr, ThermistorExpander-kicad-B_Paste.gbr, ThermistorExpander-kicad-B_SilkS.gbr, ThermistorExpander-kicad-Edge_Cuts.gbr, ThermistorExpander-kicad-F_Cu.gbr, ThermistorExpander-kicad-F_Mask.gbr, ThermistorExpander-kicad-F_Paste.gbr]
2022-01-10 chore|docs: create gerbers, update readme+images
    also got the bom working better, integrated with LCSC!
    [FanExpander-Lite-B_Cu.gbr, FanExpander-Lite-B_Mask.gbr, FanExpander-Lite-B_Paste.gbr, FanExpander-Lite-B_SilkS.gbr, FanExpander-Lite-Edge_Cuts.gbr, FanExpander-Lite-F_Cu.gbr, FanExpander-Lite-F_Mask.gbr, FanExpander-Lite-F_Paste.gbr]
2022-01-10 feat: add LCSC bom, add alignment fiducials
    redoing some BOM stuff, oh how i hate BOM management
    [FanExpander-Lite-B_Cu.gbr, FanExpander-Lite-B_Mask.gbr, FanExpander-Lite-B_Paste.gbr, FanExpander-Lite-B_SilkS.gbr, FanExpander-Lite-Edge_Cuts.gbr, FanExpander-Lite-F_Cu.gbr, FanExpander-Lite-F_Mask.gbr, FanExpander-Lite-F_Paste.gbr]
2022-01-10 feat: updating BOM, add fiducials
    JLCPCB 1206 caps are "discontinued" so moving to instock 0805
    capacitors. Updating BOM, creating LCSC importer
    [THermistorExpander-kicad_toLCSC.csv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]
2022-01-11 fix: add JST housings and crimp connectors to BOMs
    crimp connecotrs alone are like 70c, which is like 20% of the BOM??
    [FanExpander-Lite_toLCSC.csv, THermistorExpander-kicad_toLCSC.csv]
2022-01-11 chore: updating layout to new method, new LED
    new LED reverse mount footprint, should be slightly less bulky
    and make sure all the light just goes up through JST connector
    [FanExpander-kicad.kicad_pcb, FanExpander-kicad.sch]
2022-01-11 fix: update reverse LED mounts at SCH level
    were using the wrong hole pattern, not big enough!!
    [FanExpander-Lite-B_Cu.gbr, FanExpander-Lite-B_Mask.gbr, FanExpander-Lite-B_Paste.gbr, FanExpander-Lite-B_SilkS.gbr, FanExpander-Lite-Edge_Cuts.gbr, FanExpander-Lite-F_Cu.gbr, FanExpander-Lite-F_Mask.gbr, FanExpander-Lite-F_Paste.gbr]
2022-01-11 fix: clean Diode references on PCB
    [FanExpander-Lite-B_Cu.gbr, FanExpander-Lite-B_Mask.gbr, FanExpander-Lite-B_Paste.gbr, FanExpander-Lite-B_SilkS.gbr, FanExpander-Lite-Edge_Cuts.gbr, FanExpander-Lite-F_Cu.gbr, FanExpander-Lite-F_Mask.gbr, FanExpander-Lite-F_Paste.gbr]
2022-01-12 chore: changing values for BOM export
    [FanExpander-kicad.csv, FanExpander-kicad.kicad_pcb, FanExpander-kicad.sch]
2022-01-12 feat: initial routing of FE beefy boi
    [FanExpander-kicad.kicad_pcb, FanExpander-kicad.sch]
2022-01-15 feat: pcb corner fillets, silk layout
    [FanExpander-kicad.kicad_pcb, FanExpander-kicad.sch]
2022-01-16 feat: prep big expander for release
    [FanExpander-kicad-B_Cu.gbr, FanExpander-kicad-B_Mask.gbr, FanExpander-kicad-B_Paste.gbr, FanExpander-kicad-B_SilkS.gbr, FanExpander-kicad-Edge_Cuts.gbr, FanExpander-kicad-F_Cu.gbr, FanExpander-kicad-F_Mask.gbr, FanExpander-kicad-F_Paste.gbr]
2022-01-16 feat: solder paste filled jumpers
    [FanExpander-Lite-B_Cu.gbr, FanExpander-Lite-B_Mask.gbr, FanExpander-Lite-B_Paste.gbr, FanExpander-Lite-B_SilkS.gbr, FanExpander-Lite-Edge_Cuts.gbr, FanExpander-Lite-F_Cu.gbr, FanExpander-Lite-F_Mask.gbr, FanExpander-Lite-F_Paste.gbr]
2022-01-16 feat: BOM for big fan expander
    [FanExpander-kicad-toLCSC.csv, FanExpander-kicad.csv]
2022-02-01 chore|test: laser cut solder stencil tests
    .ai file did work, kapton tape stuck to itself and it applies paste pretty well!
    [FanExpander-Lite-B_Paste.dxf, FanExpander-Lite-Edge_Cuts.dxf, FanExpander-Lite-F_Paste.dxf, FanExpander-kicad-B_Paste.dxf, FanExpander-kicad-Edge_Cuts.dxf, FanExpander-kicad-F_Paste.dxf, ThermistorExpander-kicad-B_Paste.dxf, ThermistorExpander-kicad-Edge_Cuts.dxf]
2022-02-01 docs: top/bottom images, fuse holder STL
    running into an issue such that i can't export the STEP file of the
    entire system (for assembly jig), but we can find a workaround
    eventually, hopefully.
    [FanExpander-kicad.kicad_pcb]
2022-02-02 docs: assembly aid drawings, highlight which components go where
    pretty colors and labels for easier assembly stuff
2022-02-04 chore: update to KiCad 6.0, better EXP 3D model
    move to KiCad 6 in order to export step files, lol.
    Also, improve the direct EXP1 plug in so it's more accurate to size
    add local .gitignore to ignore backup files
    [FanExpander-Lite.kicad_pcb, FanExpander-Lite.kicad_sch, FanExpander-Lite.step]
2022-02-04 chore: update Thermistor expander to KiCad 6
    [ThermistorExpander-kicad.kicad_pcb, ThermistorExpander-kicad.kicad_sch, ThermistorExpander-kicad.step]
2022-02-10 docs: fix FEL version #, add LED backdrive errata
    gaaah, this backdrive is annoying. It's also an indicator that 5V
    is active on the board, but i don't really like that tbh...
2022-02-10 chore: update FE to Kicad 6, add resistor 3d comps
    [FanExpander-kicad.kicad_pcb, FanExpander-kicad.kicad_sch]
